Eljah/mercury/dist/README.md

# Готовые сборки 1.0.0

- `mercury-pi.jar`: Java 17, запускаемый JAR; включает jSerialComm 2.11.4 и нативные библиотеки ARM. Работает как UART-сервис на Pi, demo без оборудования или сетевой клиент на другом компьютере.
- `mercury-lan-uno.hex`: Arduino Uno, ATmega328P, 16 МГц, Ethernet 2.0.2.
- `mercury-lan-nano.hex`: Nano classic, ATmega328P, 16 МГц, Ethernet 2.0.2. При загрузке выберите параметры загрузчика своей платы.

HEX содержат только прикладную программу. Их исходная конфигурация: адрес счётчика 651401, UART 9600, RX D8 / TX D9, статический IP 192.168.1.50/24, шлюз 192.168.1.1, MAC 02:4D:45:52:00:01, опрос 30 с, HTTP-порт 80. При изменении параметров пересоберите исходники.

JAR без `--config` использует адрес 651401, `/dev/serial0`, 9600 бод, опрос 30 с, HTTP 0.0.0.0:8080. `--demo` открывает только сетевой API с явно помеченными синтетическими данными. Для Java 24+ при работе с реальным UART может понадобиться `--enable-native-access=ALL-UNNAMED` перед `-jar`; проверка выполнялась на Java 17.

Контрольные суммы файлов находятся в `SHA256SUMS.txt`.
