Eljah/mercury/docs/protocol.md

# Поддерживаемая часть протокола

Реализован только запрос `0x27`: четыре накопленных значения энергии T1–T4. Это протокол старой однофазной серии «Меркурий-200», **не Modbus**. Совпадающий алгоритм CRC16 не делает весь протокол Modbus.

| Поле запроса | Размер | Формат |
|---|---|---|
| Адрес | 4 байта | Беззнаковое целое, старший байт первым |
| Команда | 1 байт | `27` hex |
| CRC | 2 байта | CRC16/MODBUS, начальное `FFFF`, полином `A001`, младший байт первым |

Для адреса 651401 отправляются **7 байтов**:

```text
00 09 F0 89 27 00 25
```

Ответ имеет **23 байта**: адрес 4, команда 1, тарифы 16, CRC 2. Каждый тариф занимает 4 байта упакованного BCD, старшие десятичные разряды впереди. Полученное целое означает сотые кВт·ч. Например, `00 06 21 42` — это **621,42 кВт·ч**.

Независимый опубликованный контрольный пример из тестов драйвера Wiren Board:

```text
Запрос: FE 12 34 56 27 36 D8
Ответ:  FE 12 34 56 27 00 06 21 42 00 02 08 34 00 01 11 11 00 02 22 22 2B 25
```

Адрес этого примера — `FE123456` hex, он **не относится к вашему счётчику**. Ожидаются тарифы `621.42`, `208.34`, `111.11`, `222.22`, сумма `1163.09`. Оба декодера проверяются на этих данных. Это эталон протокола, а не реальная выборка с пользовательского оборудования.

## Эхо и восстановление границ

CAN-приёмопередатчик может вернуть на UART RX семь отправленных байтов. У SoftwareSerial эхо может отсутствовать или приниматься частично. Поэтому программы не отбрасывают безусловно «первые семь байтов». Сканер проверяет скользящее окно длиной 23 байта, нужный адрес, команду, CRC и корректность всех BCD-полубайтов.

До отправки запроса удаляются старые байты предыдущей транзакции. После отправки входной буфер не очищается, чтобы не потерять быстрый ответ. Нет автоподбора адресов и нет команд записи. Отдельный сетевой клиент не может запустить конкурентный опрос.

## Первичные источники

1. [Инкотекс: пояснение об использовании физического CAN и UART](https://doc.incotexcom.ru/protocol/mercury/). **Формат команд в этом общем современном документе относится к другим сериям**; для 200 нельзя брать оттуда однобайтовый адрес.
2. [Инкотекс: страница протоколов, отдельный документ однофазных счётчиков](https://www.incotexcom.ru/support/docs/protocol).
3. [Документ протокола, копия у производителя ОВЕН](https://ftp.owen.ru/CoDeSys3/04_Library/05_3.5.11.5/02_Libraries/02_vendor_protocols/mercury-protocol-obmena-1.pdf). В заголовке указан М206; применимость реализованной команды к серии 200 дополнительно сверена по работающему драйверу производителя контроллеров ниже.
4. [Исходный код драйвера Mercury 200, Wiren Board](https://github.com/wirenboard/wb-mqtt-serial/blob/master/src/devices/mercury200_device.cpp).
5. [Параметры 200.02: BCD32 и масштаб 0,01](https://github.com/wirenboard/wb-mqtt-serial/blob/master/templates/config-mercury200_02.json).
6. [Опубликованные тестовые кадры Wiren Board](https://github.com/wirenboard/wb-mqtt-serial/blob/master/test/mercury200_expectations.cpp), проверенный blob SHA: `bcc87fdf6adff0f35b419f86133af73439282dc0`.
7. [Руководство изготовителя с модификацией 200.03, копия Элдис](https://eldis24.ru/upload/iblock/c60/Руководство%20по%20эксплуатации%20Меркурий%20200.pdf).

Совместимость выбранного подмножества с конкретной прошивкой счётчика 2006 года требует проверки на приборе. Сбой связи нельзя превращать в нулевое потребление.
