Eljah/mercury/docs/wiring-arduino.png

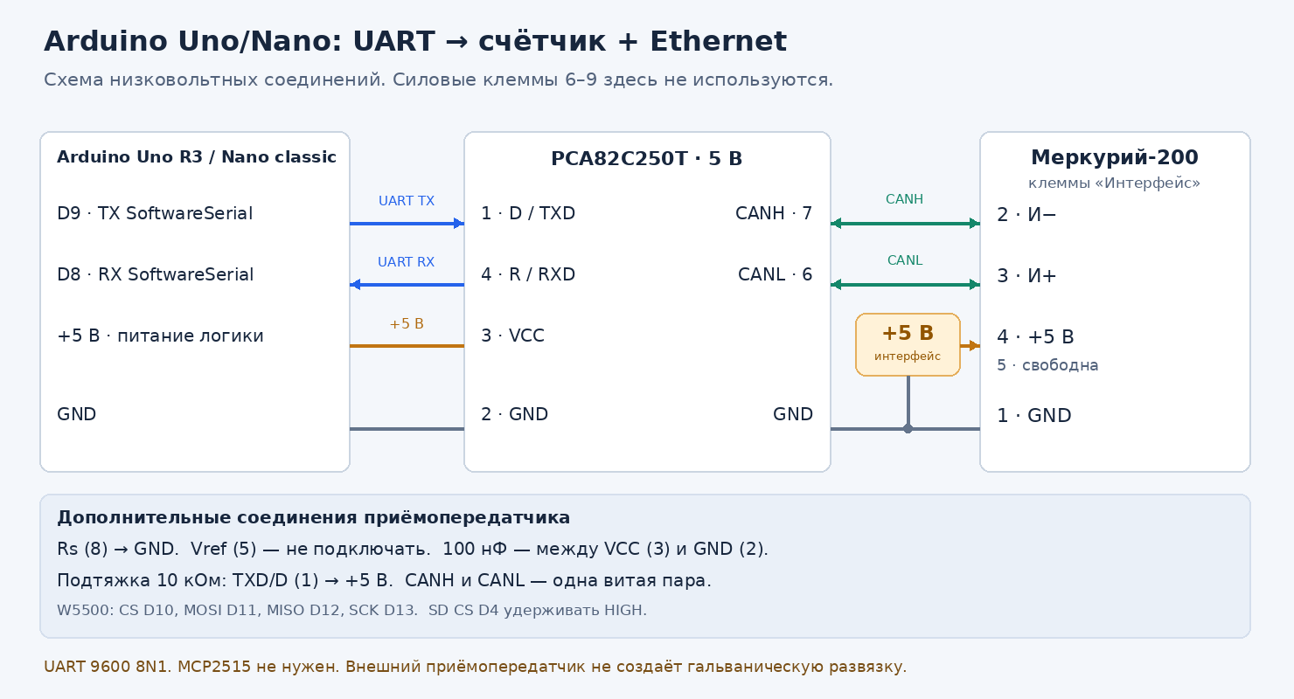
docs/wiring-arduino.png
