Eljah/mercury/docs/wiring-raspberry-pi.png

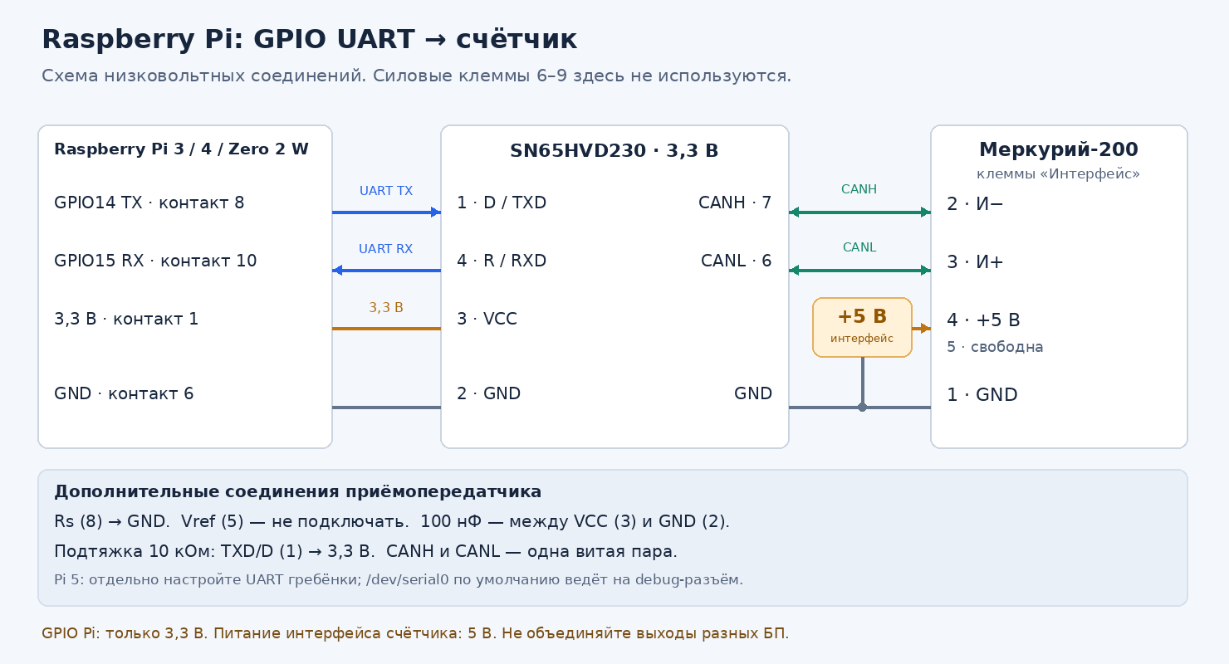
docs/wiring-raspberry-pi.png
