Eljah/mercury/docs/validation.md

# Что проверено в версии 1.0.0

Проверка выполнена 26 октября 2026 года. Физического счётчика, Arduino и Raspberry Pi в среде проверки не было.

| Проверка | Результат |
|---|---|
| Arduino Uno, Arduino AVR Boards 1.8.6, Ethernet 2.0.2 | Сборка успешна; flash 19 706 / 32 256 байт (61%) |
| Arduino Nano classic ATmega328P, те же зависимости | Сборка успешна; flash 19 706 / 30 720 байт (64%) |
| Статические данные AVR | 668 / 2048 байт SRAM; остаётся 1380 байт для стека и прочих локальных данных |
| Переносимый C++-декодер | Все проверки протокола и потока прошли |
| Java 17 / Maven | `verify` прошёл; 9 JUnit-тестов, 0 ошибок и 0 отказов |
| Запускаемый fat JAR, demo + HTTP | Успешно; поле `demo:true`; порт счётчика не открывается |
| Java HTTP-клиент из того же JAR | Успешно прочитал demo-сервис |
| Нативный jSerialComm через Linux PTY | Успешно открыт порт, отправлен запрос и прочитан ответ |
| Фрагментированный ответ с шумом и полным локальным эхо | Успешно декодирован; T1 621.42, T2 208.34, T3 111.11, T4 222.22 |
| Ошибочная CRC в следующем ответе | HTTP 503, `ok:false`; прежняя выборка сохранена, её возраст увеличивается |
| Восстановление без эха | Следующий корректный ответ принят; HTTP 200 |
| Записанные имитатором исходящие запросы | Четыре пакета, все равны `00 09 F0 89 27 00 25`; других команд не было |
| Нативные ARM-библиотеки в JAR | Проверено присутствие ARMv6hf, ARMv7hf и ARMv8/64 |
| Схемы SVG/PNG | Проверены синтаксис SVG и читаемость обеих схем |

Тесты протокола используют независимые опубликованные кадры Wiren Board, стандартный вектор CRC16/MODBUS и отдельные негативные сценарии. Проверяются неверные адрес/команда, CRC, недопустимый BCD, неполный ответ, шум и эхо.

## Воспроизведение

Из корня архива:

```bash
sh arduino/tests/run.sh
```

В `raspberry-pi/`:

```bash
mvn clean verify
```

На Linux с Java 17+ и Python 3, из корня архива:

```bash
python3 tests/serial_integration.py dist/mercury-pi.jar
```

Последняя проверка поднимает только loopback HTTP и временный псевдотерминал. Она не открывает настоящие `/dev/serial0` или GPIO и выдаёт только синтетический ответ. Не нужны внешние Python-пакеты.

## Что остаётся проверить на оборудовании

Нужно подтвердить маркировку именно вашего прибора, адрес и скорость порта, питание интерфейса, полярность проводов, устойчивость выбранной линии и совпадение T1/T2 с дисплеем. UART 9600 и физические схемы основаны на документации; их испытание на счётчике 2006 года не выполнялось. Исполняемый код готов для такого испытания, но сборка и имитация не являются подтверждением электрической совместимости конкретного экземпляра.
